cjheath/esp32lcd/esp32lcd_3d_back.png

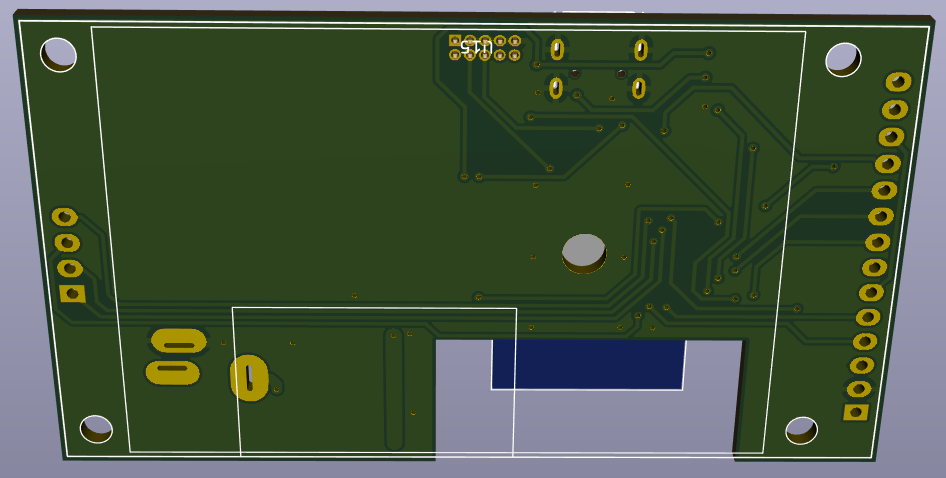
esp32lcd_3d_back.png
