cjheath/esp32lcd/esp32lcd_3d_front.png

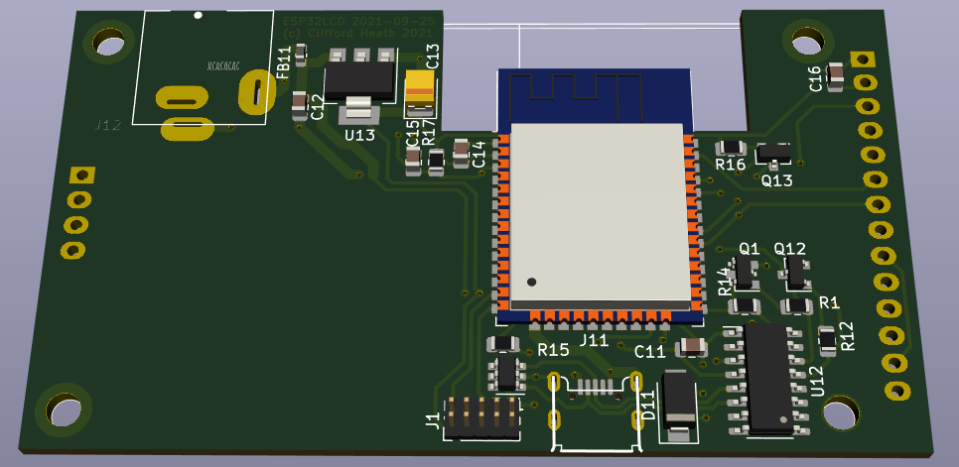
esp32lcd_3d_front.png
