cjheath/esp32lcd/esp32lcd_pcb.png

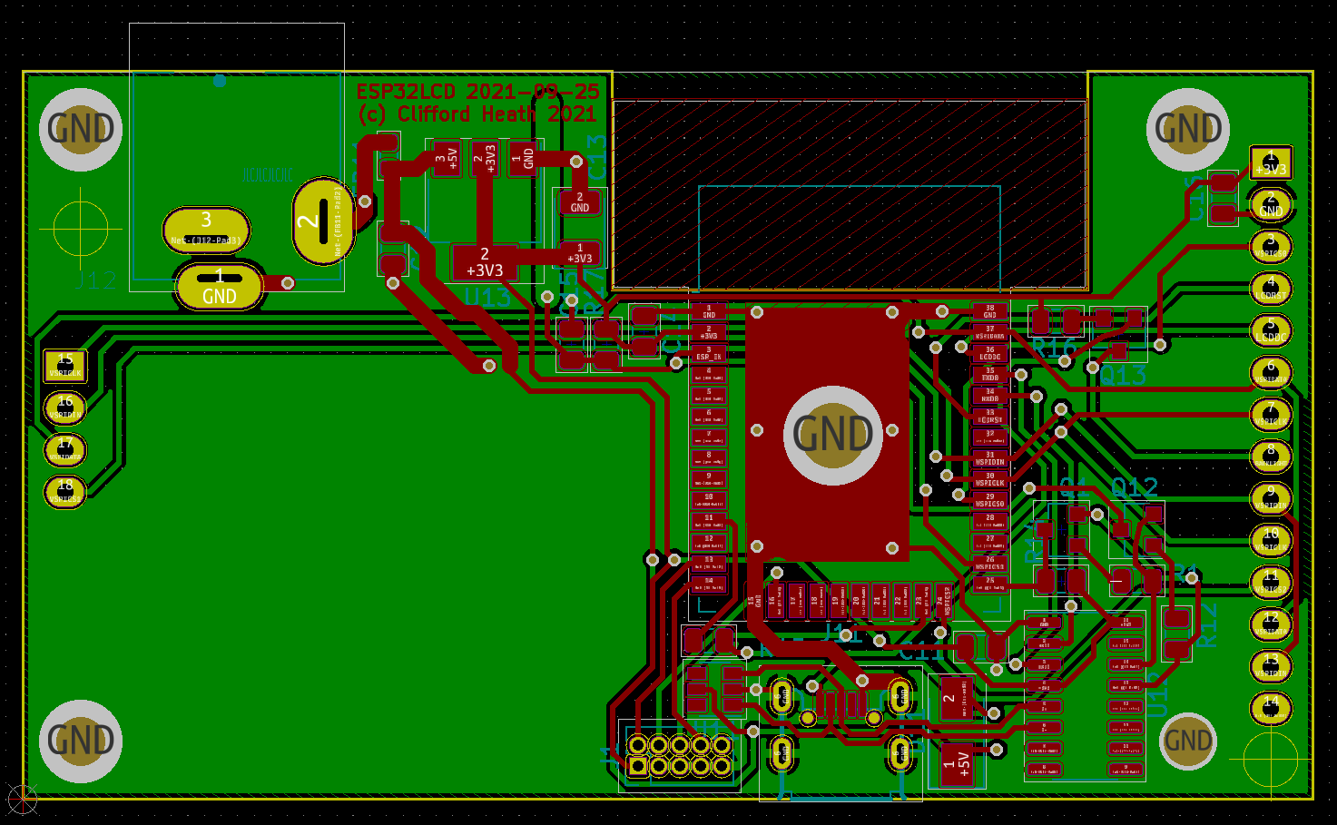
esp32lcd_pcb.png
