cjheath/esp32lcd/esp32lcd_sch.pdf

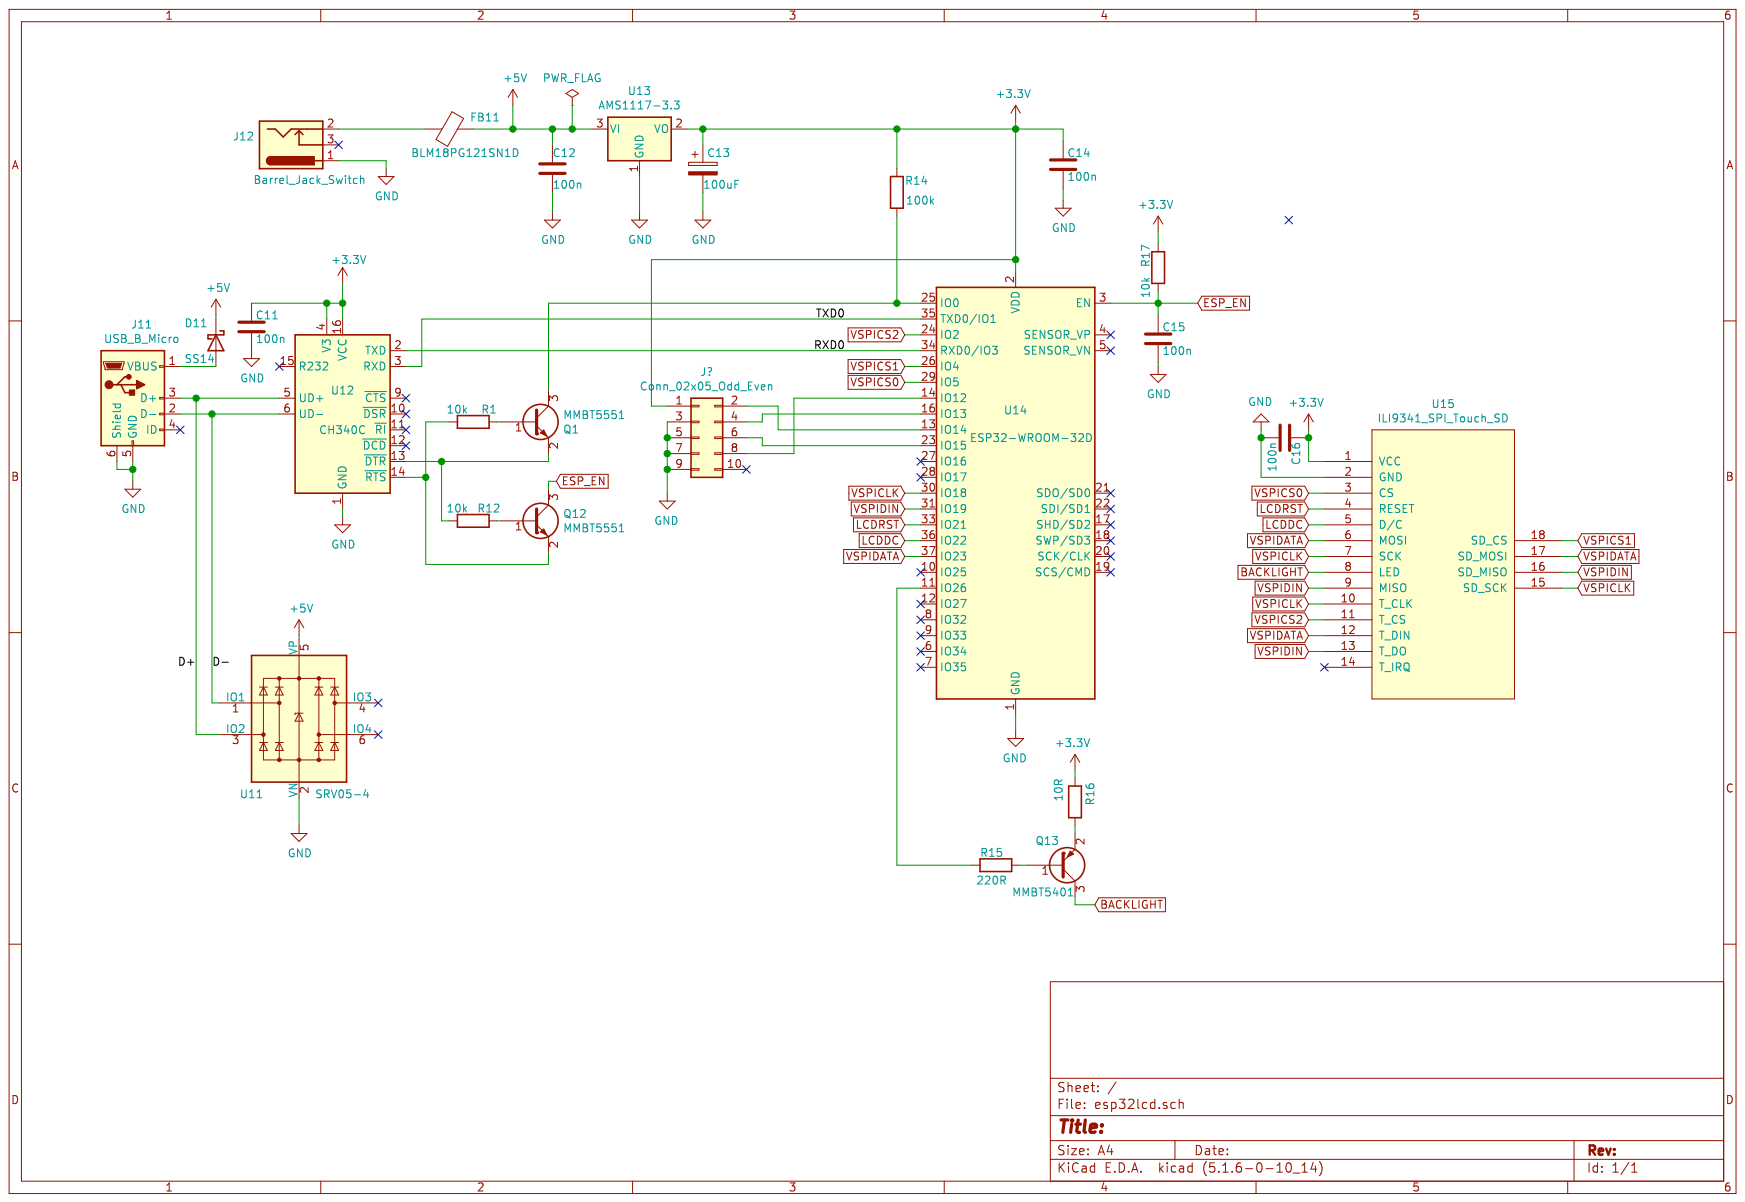
[picture p4: page 1]
