cjheath/esp32lcd/hardware/esp32lcd.kicad_pcb

## KiCad design hardware/esp32lcd.kicad_pcb (2026-06-12)

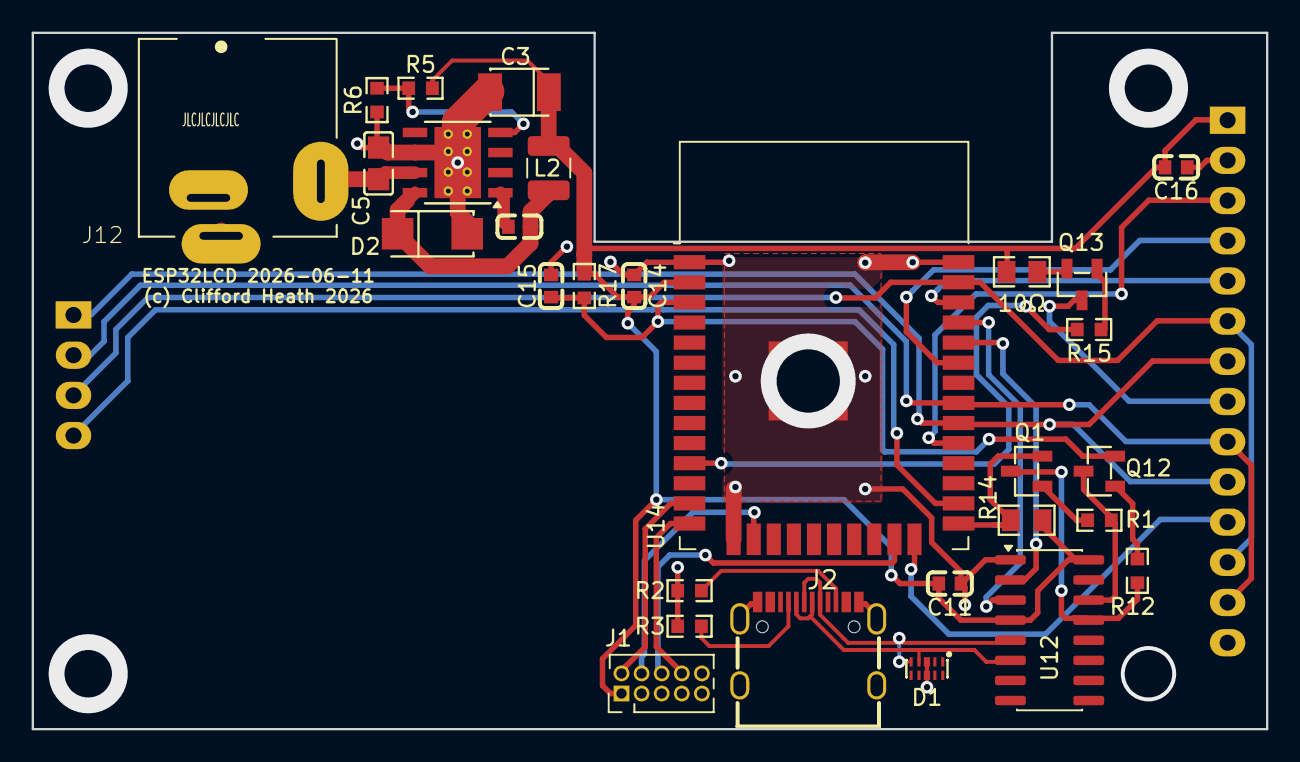
[picture p5: board esp32lcd.kicad_pcb from above]

Board: 2 copper layers, 78.0 x 44.0 mm, 30 parts (1 on the bottom side), 34 nets.

Parts:
C3: 100uF; CASE-B_3528
C4: 10nF; C0603
C5: 4.7uF; C0805
C11, C14, C15, C16: 100nF; C0603
D1: TPAZ1143-04F; DFN-10_L2.5-W1.0-P0.50-BL-A
D2: SS34; SMA_L4.3-W2.6-LS5.2-RD
J1: Conn_02x05_Odd_Even; PinHeader_2x05_P1.27mm_Vertical
J2: USB_C_Receptacle_USB2.0_14P; USB-C_SMD-TYPE-C-31-M-12
J12: Barrel_Jack_Switch; XKB-DC-009A-2.0
L2: 15µH; L_1210_3225Metric
Q1, Q12: MMBT2222A; SOT-23-3_L2.9-W1.3-P1.90-LS2.4-BR
Q13: MMBT5401; SOT-23-3_L2.9-W1.3-P1.90-LS2.4-BR
R1, R5, R12, R17: 10kΩ; R0603
R2, R3: 5.1kΩ; R0603
R6: 5.6kΩ; R0603
R14: 100kΩ; R0805
R15: 220Ω; R0603
R16: 10Ω; R0805_NEW
U3: TPS5430; TI_SO-PowerPAD-8_ThermalVias
U12: CH340C; SOIC-16_3.9x9.9mm_P1.27mm
U14: ESP32-WROOM-32D; ESP32-WROOM-32
U15: ILI9341_SPI_Touch_SD; TJCTM24024-SPI

Connections:
+3V3: C3.1, C11.2, C14.2, C16.2, J1.1, L2.2, R5.2, R14.2, R16.1, R17.1, U12.4 (V3), U12.16 (VCC), U14.2 (VDD), U15.1 (VCC)
+SUPPLY: C5.2, J12.2, U3.7 (VIN)
/D+: D1.5 (I/O_4), J2.A6 (D+), J2.B6 (D+), U12.5 (UD+)
/D-: D1.4 (I/O_3), J2.A7 (D-), J2.B7 (D-), U12.6 (UD-)
BACKLIGHT: R15.2, U14.11 (IO26)
ESP_EN: C15.2, Q12.2 (C), R17.2, U14.3 (EN)
GND: C3.2, C5.1, C11.1, C14.1, C15.1, C16.1, D1.3 (GND), D1.8 (GND), D2.2 (A), J1.3, J1.5, J1.7, J1.9, J2.A1 (GND), J2.A12 (GND), J2.SH (SHIELD), J12.1, R2.1, R3.1, R6.1, U3.6 (GND), U3.9 (GNDPAD), U12.1 (GND), U14.1 (GND), U14.15 (GND), U14.38 (GND), U14.39 (GND), U15.2 (GND)
LCDDC: U14.36 (IO22), U15.5 (D/C)
LCDLED: Q13.3 (C), U15.8 (LED)
LCDRST: U14.33 (IO21), U15.4 (RESET)
LOAD: Q1.2 (C), R14.1, U14.25 (IO0)
unnamed: C4.2, D2.1 (K), L2.1, U3.8 (PH)
unnamed: J1.2, U14.13 (IO14)
unnamed: J1.4, U14.16 (IO13)
unnamed: J1.6, U14.23 (IO15)
unnamed: J1.8, U14.14 (IO12)
unnamed: J2.A5 (CC1), R3.2
unnamed: J2.B5 (CC2), R2.2
unnamed: Q1.1 (B), R1.1
unnamed: Q1.3 (E), R12.2, U12.13 (~DTR)
unnamed: Q12.1 (B), R12.1
unnamed: Q12.3 (E), R1.2, U12.14 (~RTS)
unnamed: Q13.1 (B), R15.1
unnamed: Q13.2 (E), R16.2
unnamed: C4.1, U3.1 (BOOT)
unnamed: R5.1, R6.2, U3.4 (VSENSE)
RXD0: U12.2 (TXD), U14.34 (RXD0/IO3)
TXD0: U12.3 (RXD), U14.35 (TXD0/IO1)
VSPICLK: U14.30 (IO18), U15.7 (SCK), U15.10 (T_CLK), U15.15 (SD_SCK)
VSPICS0: U14.29 (IO5), U15.3 (CS)
VSPICS1: U14.26 (IO4), U15.18 (SD_CS)
VSPICS2: U14.24 (IO2), U15.11 (T_CS)
VSPIDATA: U14.37 (IO23), U15.6 (MOSI), U15.12 (T_DIN), U15.17 (SD_MOSI)
VSPIDIN: U14.31 (IO19), U15.9 (MISO), U15.13 (T_DO), U15.16 (SD_MISO)
