cjheath/esp32lcd/(commit log)

2021-01-11 First version esp32lcd
    [esp32lcd.kicad_pcb, esp32lcd.sch]
2021-01-11 Added initial fabrication files
    [esp32lcd-B_Cu.gbr, esp32lcd-B_Mask.gbr, esp32lcd-B_SilkS.gbr, esp32lcd-Edge_Cuts.gbr, esp32lcd-F_Cu.gbr, esp32lcd-F_Mask.gbr, esp32lcd-F_SilkS.gbr, esp32lcd-top-pos.csv]
2021-01-11 Switched TxD and RxD between the two chips
    [esp32lcd-B_Cu.gbr, esp32lcd-B_Mask.gbr, esp32lcd-B_SilkS.gbr, esp32lcd-Edge_Cuts.gbr, esp32lcd-F_Cu.gbr, esp32lcd-F_Mask.gbr, esp32lcd-F_SilkS.gbr, esp32lcd-top-pos.csv]
2021-01-12 Ditched diode steering in favour of another transistor
    [esp32lcd-B_Cu.gbr, esp32lcd-B_Mask.gbr, esp32lcd-B_SilkS.gbr, esp32lcd-Edge_Cuts.gbr, esp32lcd-F_Cu.gbr, esp32lcd-F_Mask.gbr, esp32lcd-F_SilkS.gbr, esp32lcd-top-pos.csv]
2021-05-04 Deleted GPIO2 boot pulldown
    [esp32lcd.kicad_pcb, esp32lcd.sch]
2021-09-25 Updated to add JTAG debug
    [esp32lcd-B_Cu.gbr, esp32lcd-B_Mask.gbr, esp32lcd-B_SilkS.gbr, esp32lcd-Edge_Cuts.gbr, esp32lcd-F_Cu.gbr, esp32lcd-F_Mask.gbr, esp32lcd-F_SilkS.gbr, esp32lcd-top-pos.csv]
2021-09-26 Moved hardware design into a subdirectory
    [esp32lcd.kicad_pcb, esp32lcd.sch]
2026-06-12 Last version before moving to Kicad10 and JLC Basic/Extended libraries
    [esp32lcd.kicad_pcb, esp32lcd.sch]
2026-06-12 Moved to Kicad 10 and JLC Basic/Extended parts where possible
    [esp32lcd.kicad_pcb, esp32lcd.kicad_sch, esp32lcd.sch]
